r0oland/PulseBlaster3000/README.md

# PulseBlaster3000
Custom, teensy based trigger board for various outputs

## Why the name?

In memory of the good old, "PulseBlaster" TTL Pulse Generator we used before, which was total overkill for what we did but worked quite nicely. Thank you SpinCore!
https://www.spincore.com/products/PulseBlaster/
