r0oland/PulseBlaster3000/Electronics/Teensy36_ports_pins.png

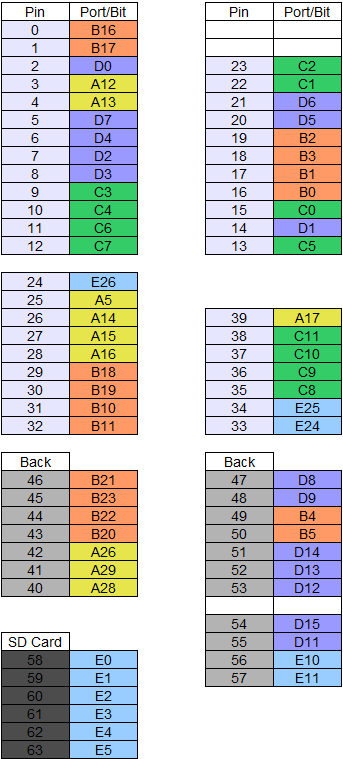
Electronics/Teensy36_ports_pins.png
