r0oland/PulseBlaster3000/Electronics/Schematic.pdf

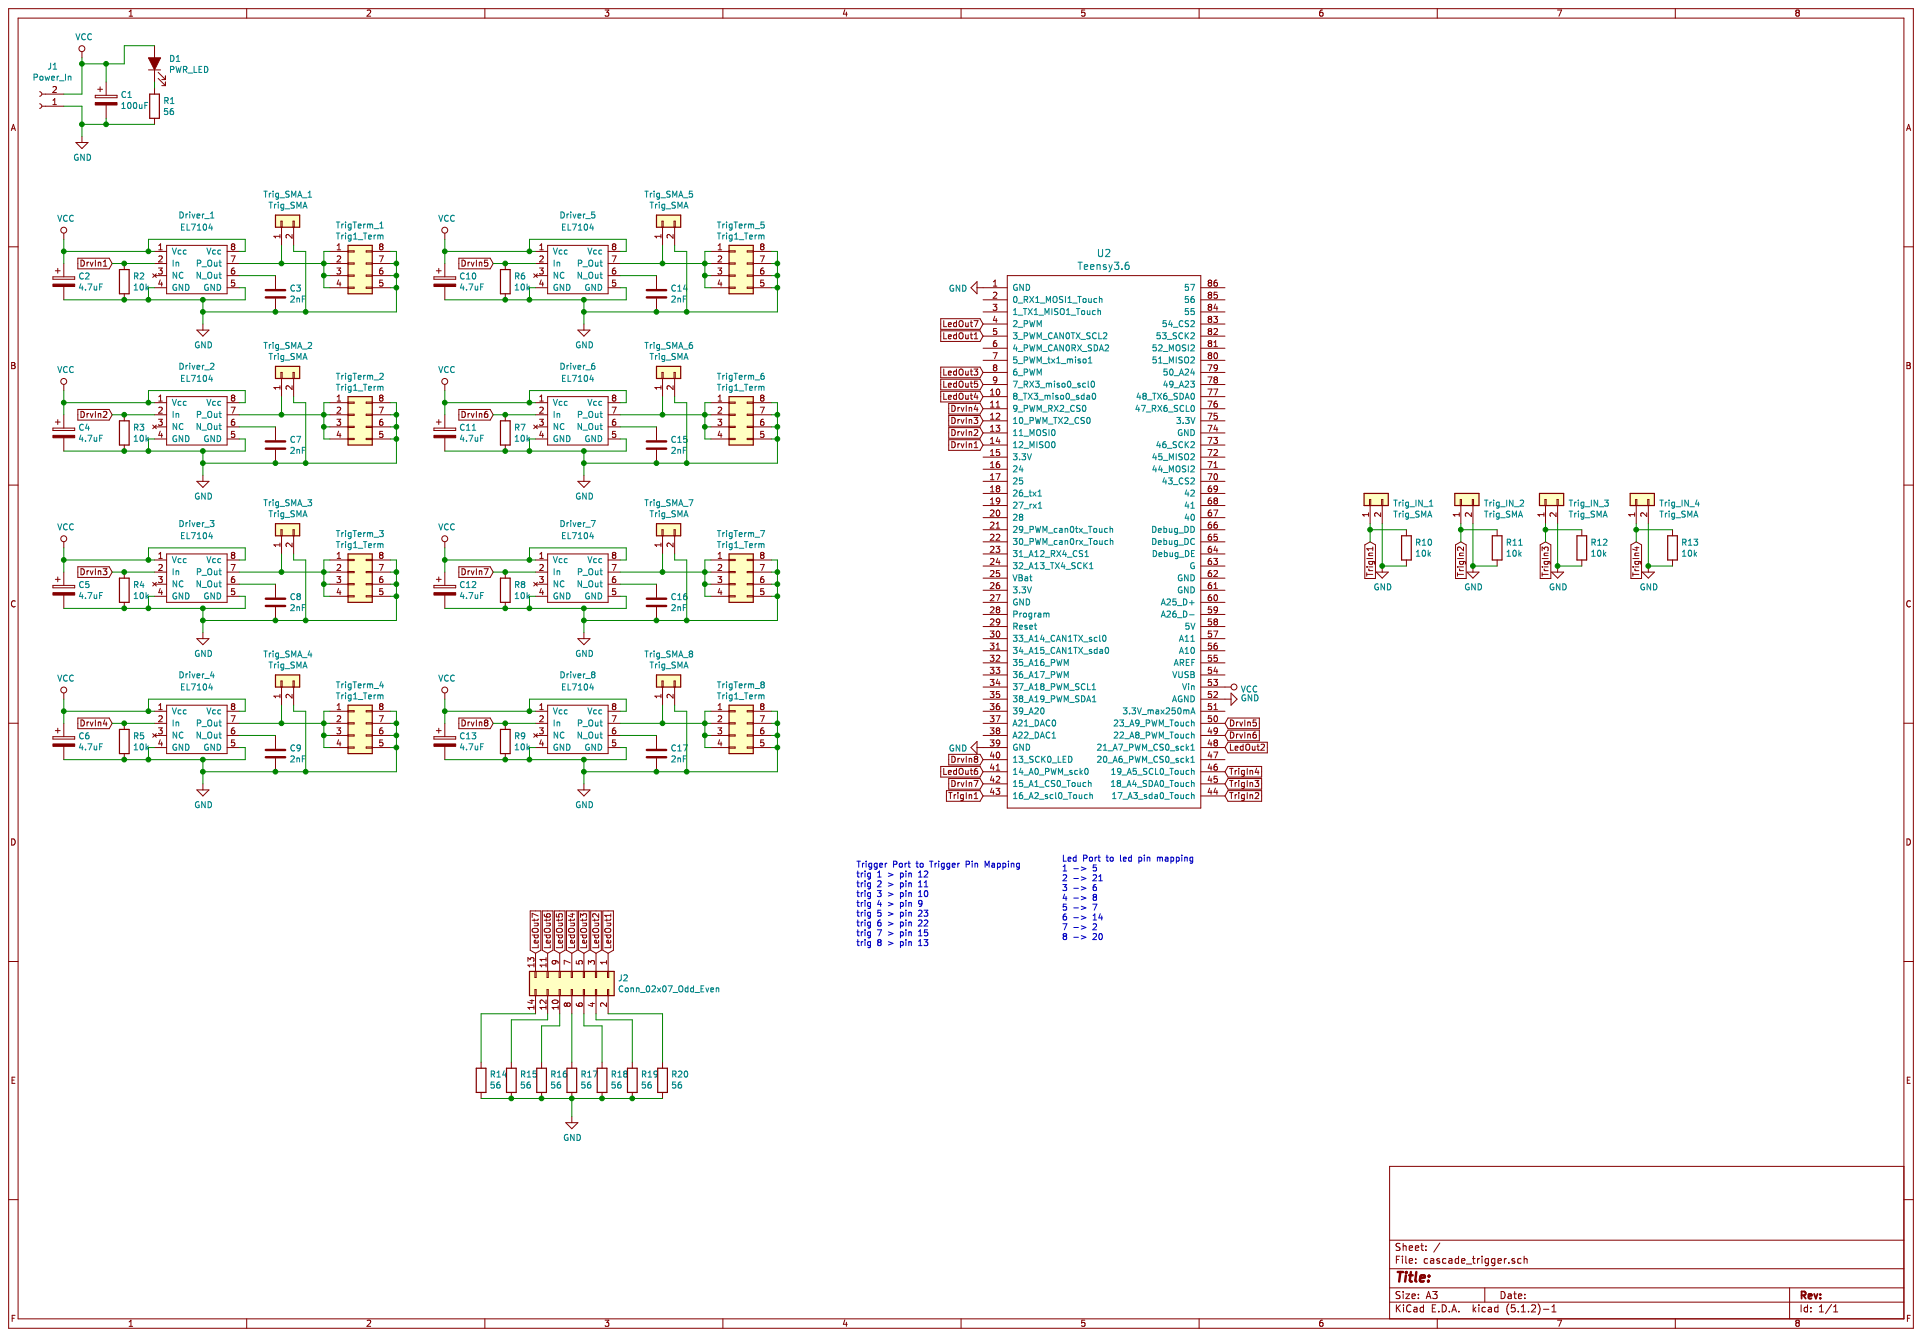
[picture p4: page 1]
