r0oland/PulseBlaster3000/Electronics/KiCad/cascade_trigger.kicad_pcb

## KiCad design Electronics/KiCad/cascade_trigger.kicad_pcb (2020-06-04)

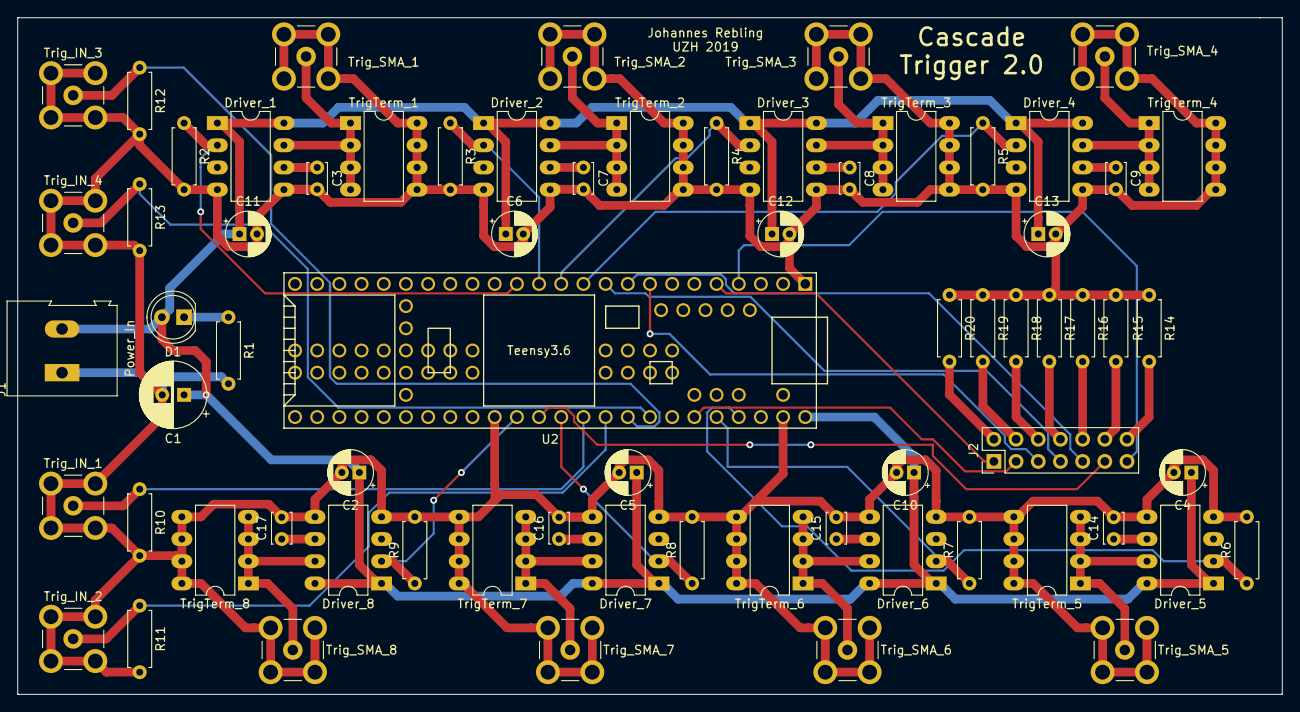
[picture p5: board cascade_trigger.kicad_pcb from above]

Board: 2 copper layers, 144.8 x 77.5 mm, 69 parts (0 on the bottom side), 45 nets.

Parts:
C1: 100uF; CP_Radial_D7.5mm_P2.50mm
C2, C4, C5, C6, C10, C11, C12, C13: 4.7uF; CP_Radial_D5.0mm_P2.00mm
C3, C7, C8, C9, C14, C15, C16, C17: 2nF; C_Disc_D3.4mm_W2.1mm_P2.50mm
D1: PWR_LED; LED_D5.0mm
Driver_1, Driver_2, Driver_3, Driver_4, Driver_5, Driver_6, Driver_7, Driver_8: EL7104; DIP-8_W7.62mm_LongPads
J1: Power_In; TerminalBlock_Altech_AK300-2_P5.00mm
J2: Conn_02x07_Odd_Even; PinHeader_2x07_P2.54mm_Vertical
R1, R14, R15, R16, R17, R18, R19, R20: 56; R_Axial_DIN0207_L6.3mm_D2.5mm_P7.62mm_Horizontal
R2, R3, R4, R5, R6, R7, R8, R9, R10, R11, R12, R13: 10k; R_Axial_DIN0207_L6.3mm_D2.5mm_P7.62mm_Horizontal
TrigTerm_1, TrigTerm_2, TrigTerm_3, TrigTerm_4, TrigTerm_5, TrigTerm_6, TrigTerm_7, TrigTerm_8: Trig1_Term; DIP-8_W7.62mm_LongPads
Trig_IN_1, Trig_IN_2, Trig_IN_3, Trig_IN_4: Trig_SMA; SMB_Jack_Vertical
Trig_SMA_1, Trig_SMA_2, Trig_SMA_3, Trig_SMA_4, Trig_SMA_5, Trig_SMA_6, Trig_SMA_7, Trig_SMA_8: Trig_SMA; SMB_Jack_Vertical
U2: Teensy3.6; Teensy35_36

Connections:
DrvIn1: Driver_1.2, R2.1, U2.14
DrvIn2: Driver_2.2, R3.1, U2.13
DrvIn3: Driver_3.2, R4.1, U2.12
DrvIn4: Driver_4.2, R5.1, U2.11
DrvIn5: Driver_5.2, R6.1, U2.50
DrvIn6: Driver_6.2, R7.1, U2.49
DrvIn7: Driver_7.2, R8.1, U2.42
DrvIn8: Driver_8.2, R9.1, U2.40
GND: C1.2, C2.2, C3.2, C4.2, C5.2, C6.2, C7.2, C8.2, C9.2, C10.2, C11.2, C12.2, C13.2, C14.2, C15.2, C16.2, C17.2, Driver_1.4, Driver_1.5, Driver_2.4, Driver_2.5, Driver_3.4, Driver_3.5, Driver_4.4, Driver_4.5, Driver_5.4, Driver_5.5, Driver_6.4, Driver_6.5, Driver_7.4, Driver_7.5, Driver_8.4, Driver_8.5, J1.1, R1.2, R2.2, R3.2, R4.2, R5.2, R6.2, R7.2, R8.2, R9.2, R10.2, R11.2, R12.2, R13.2, R14.1, R15.1, R16.1, R17.1, R18.1, R19.1, R20.1, TrigTerm_1.5, TrigTerm_1.6, TrigTerm_1.7, TrigTerm_1.8, TrigTerm_2.5, TrigTerm_2.6, TrigTerm_2.7, TrigTerm_2.8, TrigTerm_3.5, TrigTerm_3.6, TrigTerm_3.7, TrigTerm_3.8, TrigTerm_4.5, TrigTerm_4.6, TrigTerm_4.7, TrigTerm_4.8, TrigTerm_5.5, TrigTerm_5.6, TrigTerm_5.7, TrigTerm_5.8, TrigTerm_6.5, TrigTerm_6.6, TrigTerm_6.7, TrigTerm_6.8, TrigTerm_7.5, TrigTerm_7.6, TrigTerm_7.7, TrigTerm_7.8, TrigTerm_8.5, TrigTerm_8.6, TrigTerm_8.7, TrigTerm_8.8, Trig_IN_1.2, Trig_IN_2.2, Trig_IN_3.2, Trig_IN_4.2, Trig_SMA_1.2, Trig_SMA_2.2, Trig_SMA_3.2, Trig_SMA_4.2, Trig_SMA_5.2, Trig_SMA_6.2, Trig_SMA_7.2, Trig_SMA_8.2, U2.1, U2.39, U2.52
LedOut1: J2.1, U2.5
LedOut2: J2.3, U2.48
LedOut3: J2.5, U2.8
LedOut4: J2.7, U2.10
LedOut5: J2.9, U2.9
LedOut6: J2.11, U2.41
LedOut7: J2.13, U2.4
unnamed: C3.1, Driver_1.6
unnamed: C7.1, Driver_2.6
unnamed: C8.1, Driver_3.6
unnamed: C9.1, Driver_4.6
unnamed: C14.1, Driver_5.6
unnamed: C15.1, Driver_6.6
unnamed: C16.1, Driver_7.6
unnamed: C17.1, Driver_8.6
unnamed: D1.1, R1.1
unnamed: Driver_1.7, TrigTerm_1.1, TrigTerm_1.2, TrigTerm_1.3, TrigTerm_1.4, Trig_SMA_1.1
unnamed: Driver_2.7, TrigTerm_2.1, TrigTerm_2.2, TrigTerm_2.3, TrigTerm_2.4, Trig_SMA_2.1
unnamed: Driver_3.7, TrigTerm_3.1, TrigTerm_3.2, TrigTerm_3.3, TrigTerm_3.4, Trig_SMA_3.1
unnamed: Driver_4.7, TrigTerm_4.1, TrigTerm_4.2, TrigTerm_4.3, TrigTerm_4.4, Trig_SMA_4.1
unnamed: Driver_5.7, TrigTerm_5.1, TrigTerm_5.2, TrigTerm_5.3, TrigTerm_5.4, Trig_SMA_5.1
unnamed: Driver_6.7, TrigTerm_6.1, TrigTerm_6.2, TrigTerm_6.3, TrigTerm_6.4, Trig_SMA_6.1
unnamed: Driver_7.7, TrigTerm_7.1, TrigTerm_7.2, TrigTerm_7.3, TrigTerm_7.4, Trig_SMA_7.1
unnamed: Driver_8.7, TrigTerm_8.1, TrigTerm_8.2, TrigTerm_8.3, TrigTerm_8.4, Trig_SMA_8.1
unnamed: J2.2, R20.2
unnamed: J2.4, R19.2
unnamed: J2.6, R18.2
unnamed: J2.8, R17.2
unnamed: J2.10, R16.2
unnamed: J2.12, R15.2
unnamed: J2.14, R14.2
TrigIn1: R10.1, Trig_IN_1.1, U2.43
TrigIn2: R11.1, Trig_IN_2.1, U2.44
TrigIn3: R12.1, Trig_IN_3.1, U2.45
TrigIn4: R13.1, Trig_IN_4.1, U2.46
VCC: C1.1, C2.1, C4.1, C5.1, C6.1, C10.1, C11.1, C12.1, C13.1, D1.2, Driver_1.1, Driver_1.8, Driver_2.1, Driver_2.8, Driver_3.1, Driver_3.8, Driver_4.1, Driver_4.8, Driver_5.1, Driver_5.8, Driver_6.1, Driver_6.8, Driver_7.1, Driver_7.8, Driver_8.1, Driver_8.8, J1.2, U2.53
