r0oland/PulseBlaster3000/(commit log)

2020-06-04 adding firmware, kicad and matlab files
    [cascade_trigger-B_Cu.gbl, cascade_trigger-B_Mask.gbs, cascade_trigger-B_SilkS.gbo, cascade_trigger-Edge_Cuts.gm1, cascade_trigger-F_Cu.gtl, cascade_trigger-F_Mask.gts, cascade_trigger-F_SilkS.gto, cascade_trigger-NPTH.drl]
2020-06-25 before switch to teensy 41
2020-07-16 remove older files, fixed LMI bug, renamed LMI functions
    [main.cpp, trigger_lib.h]
2020-08-18 adding led strip support
